zephray/ELTerm/firmware/main.c

//
// Copyright 2021 Wenting Zhang <zephray@outlook.com>
//
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
#include <stdio.h>
#include "pico/stdlib.h"
#include "el.h"
#include "graphics.h"
#include "terminal.h"
#include "serial.h"
#include "usbhid.h"

int main()
{
    stdio_init_all();
    el_start();
    serial_init();
    usbhid_init();
    term_init();

    while(1) {
        term_loop();
    }

    return 0;
}
