zephray/ELTerm/firmware/graphics.c

//
// Copyright 2021 Wenting Zhang <zephray@outlook.com>
//
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
#include <stdio.h>
#include "pico/stdlib.h"
#include "el.h"
#include "font.h"
#include "graphics.h"

//#define GREYSCALE_3FRAME
#define GREYSCALE_2FRAME

static void _putpixel_bp(unsigned char *buf, int x, int y, int c) {
    if (c)
        buf[SCR_STRIDE * y + x / 8] |= 1 << (x % 8);
    else
        buf[SCR_STRIDE * y + x / 8] &= ~(1 << (x % 8));
}

void graph_put_pixel(int x, int y, int c) {
#ifdef GREYSCALE_3FRAME
    if (c == 3) {
        _putpixel_bp(framebuf_bp0, x, y, 1);
        _putpixel_bp(framebuf_bp1, x, y, 1);
        _putpixel_bp(framebuf_bp2, x, y, 1);
    }
    else if (c == 2) {
        if ((x & 1) ^ (y & 1)) {
            _putpixel_bp(framebuf_bp0, x, y, 1);
            _putpixel_bp(framebuf_bp1, x, y, 1);
            _putpixel_bp(framebuf_bp2, x, y, 0);
        }
        else {
            _putpixel_bp(framebuf_bp0, x, y, 0);
            _putpixel_bp(framebuf_bp1, x, y, 1);
            _putpixel_bp(framebuf_bp2, x, y, 1);
        }
    }
    else if (c == 1) {
        if ((x & 1) ^ (y & 1)) {
            _putpixel_bp(framebuf_bp0, x, y, 1);
            _putpixel_bp(framebuf_bp1, x, y, 0);
            _putpixel_bp(framebuf_bp2, x, y, 0);
        }
        else {
            _putpixel_bp(framebuf_bp0, x, y, 0);
            _putpixel_bp(framebuf_bp1, x, y, 1);
            _putpixel_bp(framebuf_bp2, x, y, 0);
        }
    }
    else {
        _putpixel_bp(framebuf_bp0, x, y, 0);
        _putpixel_bp(framebuf_bp1, x, y, 0);
        _putpixel_bp(framebuf_bp2, x, y, 0);
    }
#elif defined (GREYSCALE_2FRAME)
    if (c >= 5) {
        _putpixel_bp(framebuf_bp0, x, y, 1);
        _putpixel_bp(framebuf_bp1, x, y, 1);
    }
    else if (c == 4) {
        if ((x & 1) ^ (y & 1)) {
            _putpixel_bp(framebuf_bp0, x, y, 1);
            _putpixel_bp(framebuf_bp1, x, y, 1);
        }
        else {
            _putpixel_bp(framebuf_bp0, x, y, 0);
            _putpixel_bp(framebuf_bp1, x, y, 1);
        }
    }
    else if (c == 3) {
        if ((x & 1) ^ (y & 1)) {
            _putpixel_bp(framebuf_bp0, x, y, 1);
            _putpixel_bp(framebuf_bp1, x, y, 1);
        }
        else {
            _putpixel_bp(framebuf_bp0, x, y, 0);
            _putpixel_bp(framebuf_bp1, x, y, 0);
        }
    }
    else if (c == 2) {
        if ((x & 1) ^ (y & 1)) {
            _putpixel_bp(framebuf_bp0, x, y, 1);
            _putpixel_bp(framebuf_bp1, x, y, 0);
        }
        else {
            _putpixel_bp(framebuf_bp0, x, y, 0);
            _putpixel_bp(framebuf_bp1, x, y, 1);
        }
    }
    else if (c == 1) {
        if ((x & 1) ^ (y & 1)) {
            _putpixel_bp(framebuf_bp0, x, y, 1);
            _putpixel_bp(framebuf_bp1, x, y, 0);
        }
    }
    else {
        _putpixel_bp(framebuf_bp0, x, y, 0);
        _putpixel_bp(framebuf_bp1, x, y, 0);
    }
#endif
}

static uint8_t bp0_masks_odd[8] = {0x00, 0x55, 0x55, 0x55, 0xff, 0xff, 0xff, 0xff};
static uint8_t bp0_masks_even[8]= {0x00, 0xaa, 0xaa, 0xaa, 0xff, 0xff, 0xff, 0xff};
static uint8_t bp1_masks_odd[8] = {0x00, 0x00, 0xaa, 0x55, 0x55, 0xff, 0xff, 0xff};
static uint8_t bp1_masks_even[8]= {0x00, 0x00, 0x55, 0xaa, 0xaa, 0xff, 0xff, 0xff};

void graph_fill_rect(int x1, int y1, int x2, int y2, int c) {
    if (((x1 % 8) == 0) && ((x2 % 8) == 0) && ((y1 % 2) == 0) && ((y2 % 2) == 0)) {
        uint8_t bp0_mask_odd  = bp0_masks_odd[c];
        uint8_t bp0_mask_even = bp0_masks_even[c];
        uint8_t bp1_mask_odd  = bp1_masks_odd[c];
        uint8_t bp1_mask_even = bp1_masks_even[c];
        int stride = SCR_STRIDE - ((x2 - x1) / 8);
        uint8_t *dst0 = framebuf_bp0 + y1 * SCR_STRIDE + x1 / 8;
        uint8_t *dst1 = framebuf_bp1 + y1 * SCR_STRIDE + x1 / 8;
        for (int y = y1; y < y2; y++) {
            for (int x = x1; x < x2; x+=8) {
                *dst0++ = (y & 1) ? bp0_mask_odd : bp0_mask_even;
                *dst1++ = (y & 1) ? bp1_mask_odd : bp1_mask_even;
            }
            dst0 += stride;
            dst1 += stride;
        }
    }
    else {
        for (int y = y1; y < y2; y++) {
            for (int x = x1; x < x2; x++) {
                graph_put_pixel(x, y, c);
            }
        }
    }
}

void graph_put_mono(int x, int y, int width, int height, char *pimage, char cl_fg, char cl_bg)
{
	int i,j,k,pixel,rx=0,ry=0;
	unsigned char p;
	int iwidth = width/8 + (width % 8 ? 1:0);
	for (i = 0; i < height; ++i, pimage += iwidth)
	{
		ry = y + i;
		if (ry >= SCR_WIDTH)
            return;
		else if (ry < 0)
            continue;
		for (j = 0; j < iwidth; ++j) {
			p = pimage[j];
			for (k = 0; k < 8; ++k) {
				rx = x+(8-k)+8*j;
				pixel = p % 2;
				p>>=1;
				if (pixel)
                    graph_put_pixel(rx - 1, ry, cl_fg);
				else
                    graph_put_pixel(rx - 1, ry, cl_bg);
			}
		}
	}
}
/*
void graph_put_char(int x, int y, char c, char cl_fg, char cl_bg) {
    graph_fill_rect(x, y, x + 8, y + 2, cl_bg);
    graph_put_mono(x, y + 2, 8, 12, charMap_ascii[c] , cl_fg , cl_bg);
    graph_fill_rect(x, y + 14, x + 8, y + 16, cl_bg);
}*/

static uint8_t graph_text_processing(uint8_t p, int y, char flags) {
    if (flags & FLAG_BOLD)
        p |= p << 1;
    if (flags & FLAG_ITALIC) {
        if (y < 6)
            p = p << 1;
        else if (y > 7)
            p = p >> 1;
    }
    if (flags & FLAG_STHROUGH) {
        if (y == 8)
            p = 0xff;
    }
    return p;
}

void graph_put_char(int x, int y, char c, char cl_fg, char cl_bg, char flags) {
    uint8_t *src = charMap_ascii[c];
    uint8_t *dst;
    int x_byte = x / 8;
    uint8_t *dst0 = framebuf_bp0 + y * SCR_STRIDE + x_byte;
    uint8_t *dst1 = framebuf_bp1 + y * SCR_STRIDE + x_byte;
    char fg, bg;
    if (flags & FLAG_INVERT) {
        fg = cl_bg;
        bg = cl_fg;
    }
    else {
        fg = cl_fg;
        bg = cl_bg;
    }
        
    uint8_t bg_bp0_mask_odd  = bp0_masks_odd[bg];
    uint8_t bg_bp0_mask_even = bp0_masks_even[bg];
    uint8_t bg_bp1_mask_odd  = bp1_masks_odd[bg];
    uint8_t bg_bp1_mask_even = bp1_masks_even[bg];
    uint8_t fg_bp0_mask_odd  = bp0_masks_odd[fg];
    uint8_t fg_bp0_mask_even = bp0_masks_even[fg];
    uint8_t fg_bp1_mask_odd  = bp1_masks_odd[fg];
    uint8_t fg_bp1_mask_even = bp1_masks_even[fg];

    *dst0 = bg_bp0_mask_even;
    *dst1 = bg_bp1_mask_even;
    dst0 += SCR_STRIDE; dst1 += SCR_STRIDE;
    *dst0 = bg_bp0_mask_odd;
    *dst1 = bg_bp1_mask_odd;
    dst0 += SCR_STRIDE; dst1 += SCR_STRIDE;

    for (int i = 0; i < 6; i++) {
        uint8_t p = *src++;
        p = graph_text_processing(p, i * 2 + 2, flags);
        *dst0 = (p & fg_bp0_mask_even) | (~p & bg_bp0_mask_even);
        *dst1 = (p & fg_bp1_mask_even) | (~p & bg_bp1_mask_even);
        dst0 += SCR_STRIDE; dst1 += SCR_STRIDE;
        p = *src++;
        p = graph_text_processing(p, i * 2 + 3, flags);
        *dst0 = (p & fg_bp0_mask_odd) | (~p & bg_bp0_mask_odd);
        *dst1 = (p & fg_bp1_mask_odd) | (~p & bg_bp1_mask_odd);
        dst0 += SCR_STRIDE; dst1 += SCR_STRIDE;
    }

    *dst0 = (flags & FLAG_UNDERLINE) ? fg_bp0_mask_even : bg_bp0_mask_even;
    *dst1 = (flags & FLAG_UNDERLINE) ? fg_bp0_mask_even : bg_bp1_mask_even;
    dst0 += SCR_STRIDE; dst1 += SCR_STRIDE;
    *dst0 = bg_bp0_mask_odd;
    *dst1 = bg_bp1_mask_odd;
}

void graph_put_char_small(int x, int y, char c, char cl_fg, char cl_bg) {
    int i, j, p;
	for(i = 0; i < 6; i++)
	{
		for(j = 8; j > 0; j--)
		{
			p = charMap_ascii_mini[(unsigned char)c][i] << j ;
			if (p & 0x80)
                graph_put_pixel(x + i, y + 8 - j, cl_fg);
            else
                graph_put_pixel(x + i, y + 8 - j, cl_bg);
		}
	}
}
