zephray/ELTerm/(commit log)

2021-03-26 - Support USB keyboard; Move UART; Handle more escape sequences
2021-04-11 - Add more tests, fix various sequence handling bugs
    [termcore.c]
2021-04-11 - PCB r0.2
    [ELTerm.kicad_pcb, ELTerm.kicad_sch]
2022-01-07 - Fix PCB EL pin assignment
    [ELTerm.kicad_pcb, ELTerm.kicad_sch]
2022-03-01 - Update to work with r0.2 PCB - Update to compile with new tinyUSB library - General fixes
    [el.h, termcore.c, termcore.h, terminal.c, terminal.h, tusb_config.h, usbhid.c]
2022-03-23 - Break terminal main into init and loop - Fix cursor handling
    [graphics.c, main.c, termcore.c, terminal.c, terminal.h]
