zephray/ELTerm/(notices)

Notices in the files:
hardware/ELTerm.kicad_pcb:
(C) 2021 Wenting Zhang
